bialek1997/Projekt_Automatyka_2/Matlab/Notatka 2.jpg

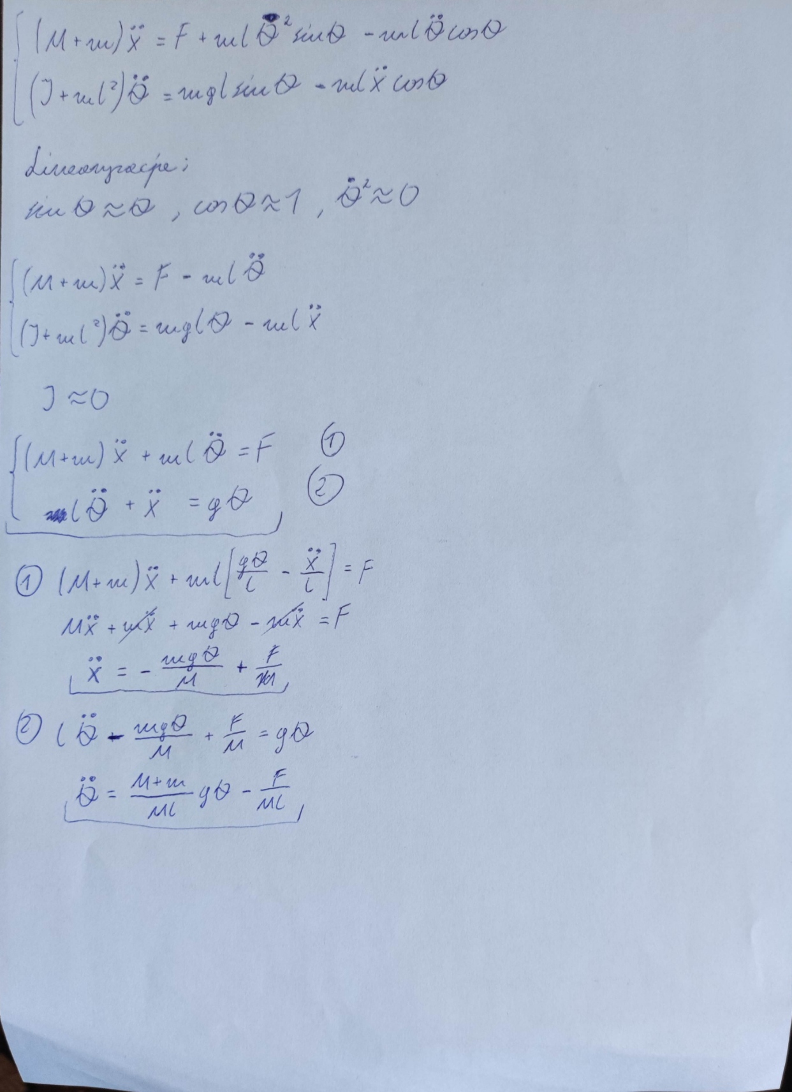
Matlab/Notatka 2.jpg
