bialek1997/Projekt_Automatyka_2/Matlab/Notatka 3.jpg

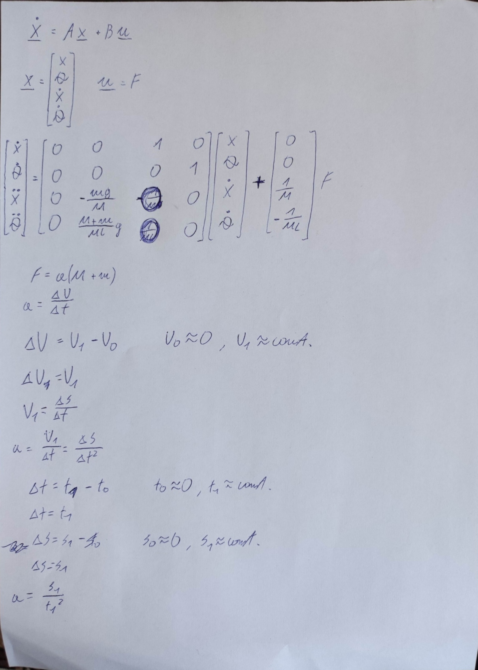
Matlab/Notatka 3.jpg
