bialek1997/Projekt_Automatyka_2/Zakupy.docx

Botland:

1x

https://botland.com.pl/silniki-krokowe/4849-silnik-krokowy-jk35hy26-0284-200-krokowobr-74v06a006nm-5904422306212.html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

1x

https://botland.com.pl/sterowniki-silnikow-moduly/15916-tb6612-dwukanalowy-sterownik-silnikow-135v12a-ze-zlaczami-adafruit-2448-5904422324995.html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

4x

https://botland.com.pl/kola-z-oponami/14245-kolo-z-opona-65x26mm-zolte.html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

ABC-RC:

4x

https://abc-rc.pl/product-pol-10260-Lacznik-osi-adapter-z-5mm-na-8mm-na-wal-silnika-os.html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

4x

https://abc-rc.pl/product-pol-9226-Lozysko-samonastawne-w-aluminiowej-obudowie-KP08-8mm-podpora-walka.html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

1x

https://abc-rc.pl/product-pol-9744-Zebatka-GT2-High-Quality-36-zebow-os-8mm-na-pasek-6mm-Drukarka-3D-RepRap-3D-CNC.html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

1x

https://abc-rc.pl/product-pol-9741-Zebatka-GT2-High-Quality-36-zebow-os-5mm-na-pasek-6mm-Drukarka-3D-RepRap-3D-CNC.html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

3 metry

https://abc-rc.pl/product-pol-6733-Pasek-zebaty-GT2-Black-napedowy-szerokosc-6mm-Tasma-do-drukarki-3D-CNC.html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

Nie wiem jak z prętami, daje te chromowane, najwyżej będzie trzeba zetrzeć warstwę chromu:

https://abc-rc.pl/product-pol-16557-Oska-5x150mm-chromowana-walek-do-budowy-robotow-i-projektow-DIY.html

i 2x:

https://abc-rc.pl/product-pol-16556-Oska-8x100mm-chromowana-walek-do-budowy-robotow-i-projektow-DIY.html

Nettigo:

2x

https://nettigo.pl/products/ogniwo-18650-li-ion-samsung-2800mah-z-zabezpieczeniem-pcm-nowe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

Oprócz tej listy za pewne będą do kupienia w castoramie czy coś takiego:

- dystanse nylonowe czy jakie się zajdzie -> najlepiej 40mm (20sztuk) ale pewnie nie ma to 20mm (40sztuk)

- kijek jakiś do wahadła

- kątowniki do trzymania wahadła i do zamontowania silnika

- śruby montażowe, w tym 20 sztuk śrub m4 o długości około 60mm

- pewnie jeszcze czegoś zapomniałem
