bialek1997/Projekt_Automatyka_2/Ćwiczenie 1 - Maciej Białecki.docx

Laboratorium

sterowania optymalnego

Sprawozdanie: Ćwiczenie 1 – Odwrócone wahadło

Autor: Maciej Białecki nr 239395

1. Wstęp

Celem ćwiczenia była adaptacja sterowania LQR dla zamodelowanego obiektu odwróconego wahadła zamocowanego na wózku poruszającego się w osi poziomej. Ze względu na zbieżność ćwiczenia z projektem realizowanym z innego przedmiotu „Projekt Automatyka II” postanowiłem scalić zdobytą wiedzę oraz umiejętności i opisać rzeczywisty przypadek omawianego urządzenia.

2. Obiekt rzeczywisty

Projektowane wahadło odwrócone składa się z dwóch głównych elementów:

1. Wózka
2. Wahadła

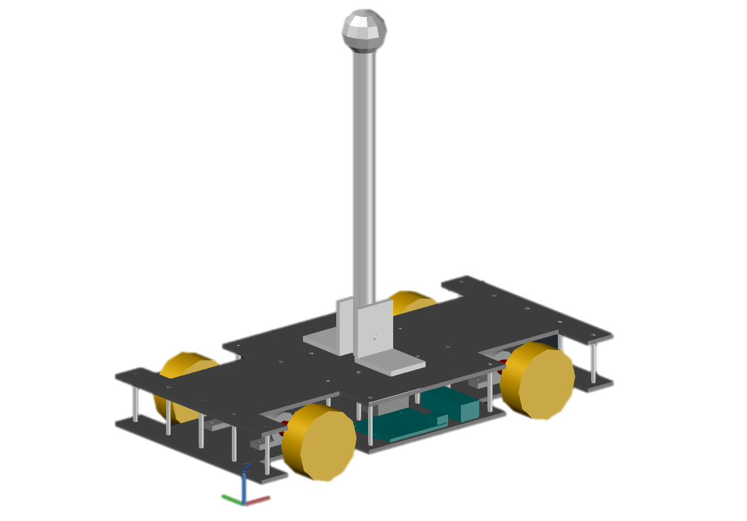
[picture p3: figure]
Obraz zawierający lego, zabawka Opis wygenerowany automatycznie

Wózek

Wahadło

Rysunek 2.1 – Model 3D wahadła odwróconego

gdzie za poruszanie się obiektu odpowiedzialny jest silnik krokowy JK42HS48-0806 dysponujący momentem obrotowym 0.31 Nm. Moment przekazywany jest na wał za pomocą przekładni z paskiem zębatym. Przy zastosowaniu kół o średnicy 67 mm maksymalna siła może mieć wartość:

F_(MAX) = M/(r∙sinα)≈(0.31 Nm)/(0.0335 m∙1)≈9.25 N

Wartość ta będzie istotna przy ograniczeniu naszego modelu.

Regulator LQR zostanie zaimplementowany w układzie mikroprocesorowym Arduino Uno REV3 (Klon) z zegarem 16MHz. Odczyt wychylenia wahadła będzie interpretowany z danych żyroskopu poprzez komunikację szeregową.

Za zasilanie urządzenia odpowiadają akumulatory Li – Ion, a tryb pracy urządzenia będzie ustalany poprzez aplikację mobilną i komunikację Bluetooth.

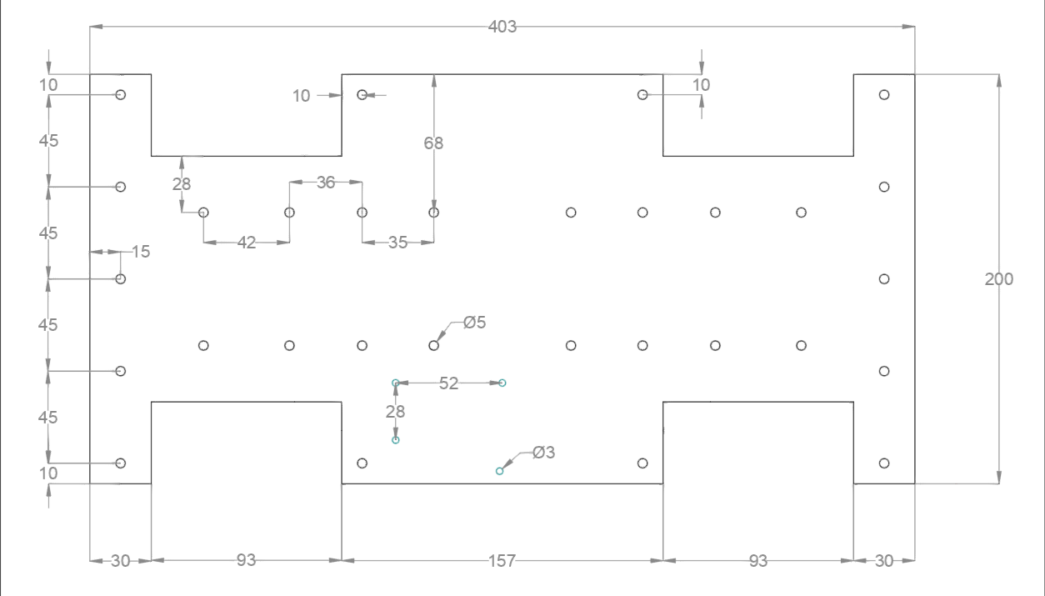
[picture p4: figure]

Rysunek 2.2 – Wymiary platformy wózka

Konstrukcja urządzenia charakteryzuje się szerokością 200 mm oraz długością wynoszącą 403 mm. Samo wahadło od punktu zaczepienia na długość 500 mm, a waga wahadła wynosi około 1.5 kg.

3. Model matematyczny wahadła odwróconego

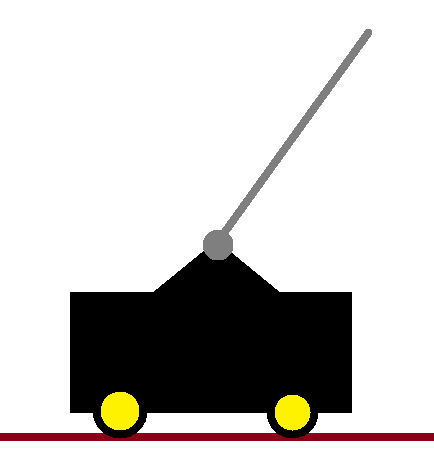
[picture p5: figure]

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
Rysunek 3.1 – Schemat wahadła odwróconego

gdzie:

- L – długość wahadła od punktu podparcia do środka ciężkości (w przybliżeniu połowa długości wahadła)
- Θ – kąt wychylenia wahadła od osi pionowej
- F – siła działająca na obiekt
- Fx – siła działająca na wahadło w osi X
- Fy – siła działająca na wahadło w osi Y
- M – masa wózka
- m – masa wahadła

Ponieważ rozważany jest obiekt rzeczywisty, siła tarcia nie została uwzględniona. Wynika to z faktu iż takie dane mogą zostać wyznaczone dopiero na etapie testów i są zależne od warunków w jakich będzie poruszać się wahadło.

Pozycje wahadła można określić za pomocą wzorów:

x_w =x+L∙sinθ y_w =L∙cosθ

gdzie: x – położenie wahadła w osi X

Równania sił dla całego obiektu:

- oś X: M∙x=F-F_x
- oś Y: F_y -m∙g=m∙y_w

Rozważamy oś X, należy wyznaczyć Fx :

F_x =m∙x_w

więc:

x_w =x+L∙θ∙cosθ

x_w =x-L∙θ^2 ∙sinθ+L∙θ∙cosθ

możemy wyznaczyć Fx :

F_x =m∙(x-L∙θ^2 ∙sinθ+L∙θ∙cosθ)

znając Fx możemy podstawić pod równanie sił w osi X:

M∙x=F-m∙(x-L∙θ^2 ∙sinθ+L∙θ∙cosθ)

ostatecznie:

(M+m)∙x=F+m∙L∙θ^2 ∙sinθ+m∙L∙θ∙cosθ

Rozważamy oś Y, należy wyznaczyć yw :

y_w =-L∙θ∙sinθ

y_w =-L∙θ^2 ∙cosθ-L∙θ∙sinθ

ostatecznie:

F_y -m∙g=m∙(-L∙θ^2 ∙cosθ-L∙θ∙sinθ)

Suma momentów działająca na wahadło względem środka ciężkości może być dana wzorem:

F_y ∙L∙ sinθ-F_x ∙L∙ cosθ=I∙θ

gdzie I – moment bezwładności wahadła

Wykorzystując powyższą zależność i podstawiając siły działające na poszczególne osie otrzymujemy:

(m∙g+m∙(-L∙θ^2 ∙cosθ-L∙θ∙sinθ))∙L∙ sinθ-

-m∙(x-L∙θ^2 ∙sinθ+L∙θ∙cosθ)∙L∙ cosθ=I∙θ

ostatecznie:

m∙g∙L∙sinθ-m∙L^2 ∙θ-m∙x∙L∙cosθ=I∙θ

Pozwala nam to na wyznaczenie zestawu równań opisujących nieliniowy model matematyczny wahadła odwróconego:

(M+m)∙x=F+m∙L∙θ^2 ∙sinθ+m∙L∙θ∙cosθ

(I+m∙L^2 )∙θ=m∙g∙L∙sinθ-m∙x∙L∙cosθ

4. Linearyzacja i zapis w przestrzeni stanów modelu wahadła odwróconego

Dla zlinearyzowanego opisu matematycznego należy przyjąć, że żyroskop zamontowany na wahadle jest nieważki dzięki czemu moment bezwładności:

I≈0

oraz:

sinθ≈θ cosθ≈1 θ^2 ≈0

Dla takich rozważań zestaw równań ma postać:

(M+m)∙x=F-m∙L∙θ

x+L∙θ=g∙θ

po przekształceniu:

x=-(m∙g∙θ)/M+F/M

θ=(M+m)/(M∙L)∙g∙θ-F/(M∙L)

Zapis w przestrzeni stanów:

x=Ax+Bu

gdzie:

x=[xθxθ] u=F

ostatecznie:

[xθxθ]=[0, 0, 1, 00, 0, 0, 10, -(m∙g)/M, 0, 00, (M+m)/(M∙L)∙g, 0, 0][xθxθ]+[001/M-1/(M∙L)]F

5. Realizacja układu w programie Matlab oraz Simulink

Model nieliniowy wahadła odwróconego można zbudować korzystając z wzorów:

(M+m)∙x=F+m∙L∙θ^2 ∙sinθ+m∙L∙θ∙cosθ

(I+m∙L^2 )∙θ=m∙g∙L∙sinθ-m∙x∙L∙cosθ

gdzie:
I≈0

ostatecznie:

(M+m)∙x=F+m∙L∙θ^2 ∙sinθ+m∙L∙θ∙cosθ

m∙L^2 ∙θ=m∙g∙L∙sinθ-m∙x∙L∙cosθ

Dla takich równań obiekt ma postać:

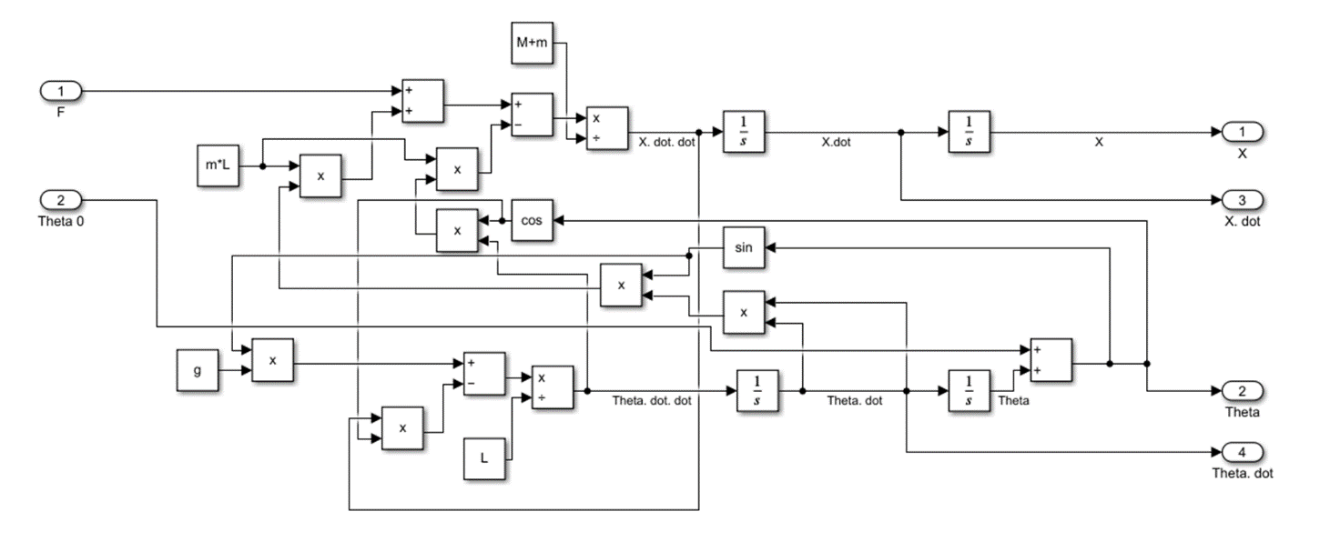
[picture p6: figure]

Rysunek 5.1 – Model obiektu zrealizowanego w Simulinku

gdzie Theta 0 to wartość początkowa wychylenia wahadła od osi pionowej. Układ z zaimplementowanym regulatorem LQR ma postać:

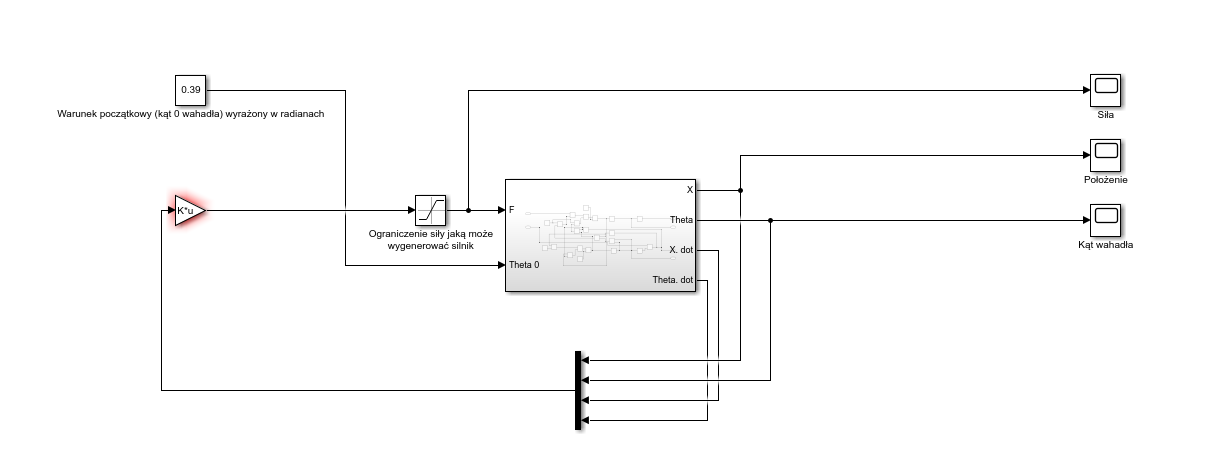
[picture p7: figure]

Rysunek 5.2 – Układ z regulatorem LQR zrealizowany w Simulinku

Dla takiego układu niezbędne jest wyznaczenie parametrów regulatora LQR. W tym celu wykorzystałem wbudowaną metodę lqr(). Skrypt dla przykładowych ustawień ma postać:

M = 1.5; %Masa platformy

m = 0.2; %Masa wahadła

L = 0.25; %Długość od mocowania wahadła do środka ciężkości

g = 9.80665; %Przyśpieszenie ziemskie

A = [0, 0, 1, 0;

0, 0, 0, 1;

0, -(m*g/M), 0, 0;

0, ((M+m)/M*L)*g, 0, 0];

B = [0;

0;

(1/M);

-(1/M*L)];

C = [1, 1, 1, 1];

D = 0;

%Test na obserwowanie

ob = obsv(A,C);

rank(ob);

%Test na sterowanie

ct = ctrb(A,B);

rank(ct);

Q = diag([1000, 100, 0, 0]);

R = 1;

K = lqr(A,B,Q,R);

Przy badaniu układu rozważane będą dwa warianty stabilizacji wahadła:

a) Powrót wahadła do pionu, Θ=0° w ciągu 5 sekund od wartości początkowej wynoszącej Θ0=45°.
b) Powrót wahadła do pionu, Θ=0° od wartości początkowej wynoszącej Θ0=45° z ograniczeniem siły wynikającej z specyfikacji użytego silnika FMAX=9.25 N.

Wariant a)

Dla stabilizacji w czasie 5 sekund najlepiej prezentują się parametry:

Q= [1, 0, 0, 00, 1000, 0, 00, 0, 500, 00, 0, 0, 0], R=1

Kąt wychylenia wahadła:

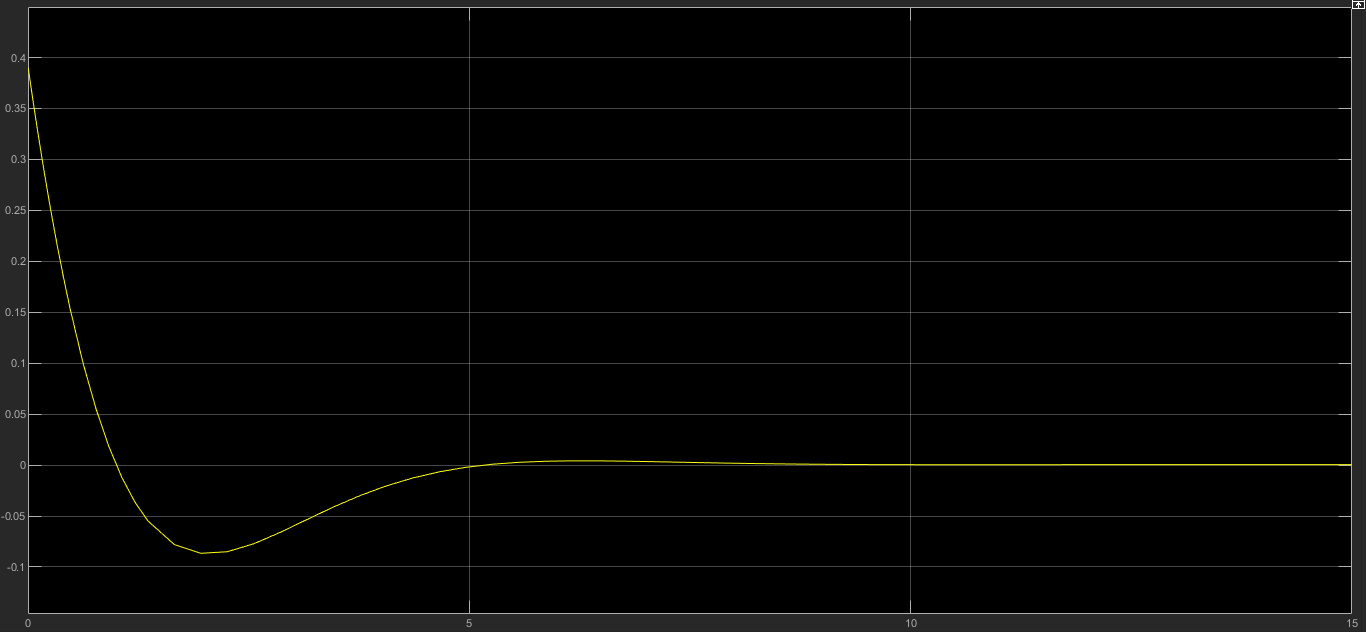
[picture p8: figure]

Położenie wózka:

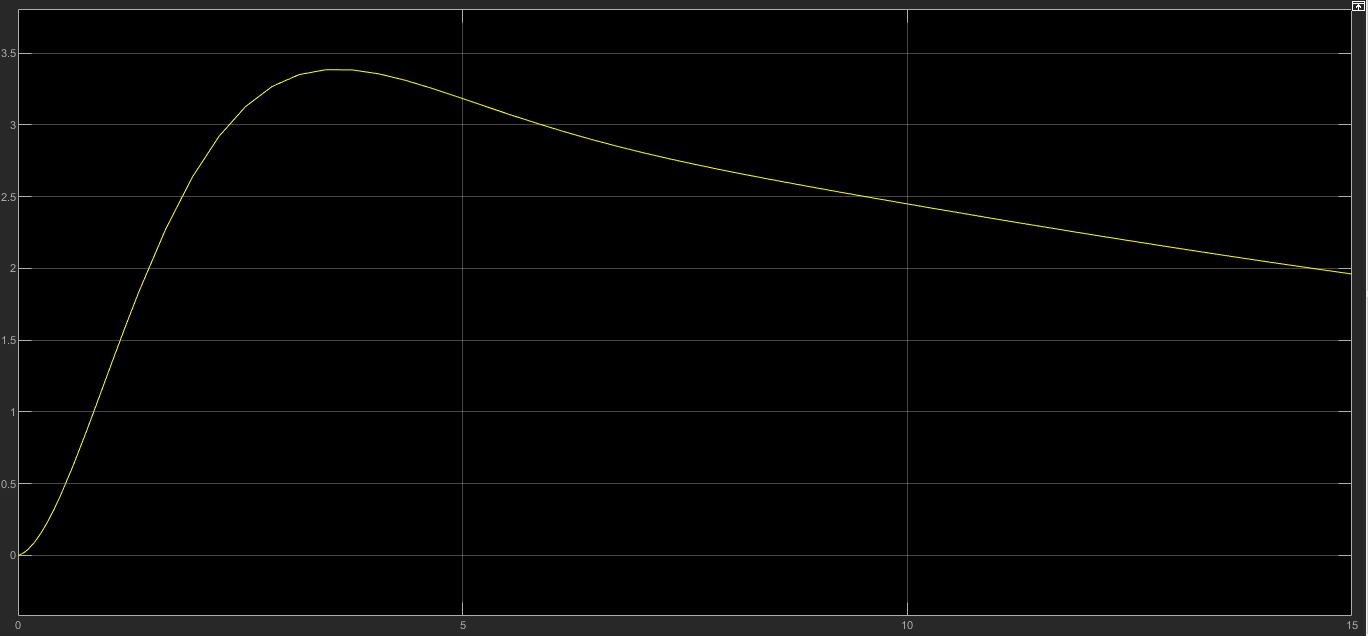
[picture p9: figure]

Położenie wózka – do momentu zatrzymania (80 sekund):

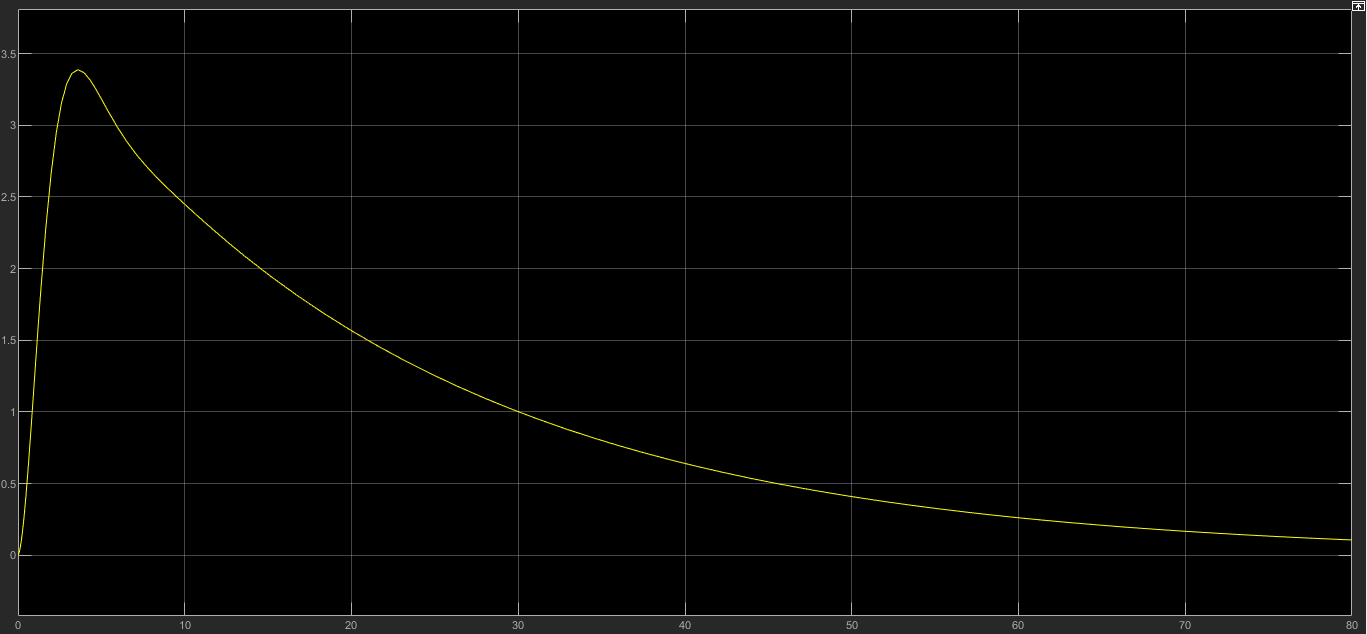
[picture p10: figure]

Siła generowana przez silnik:

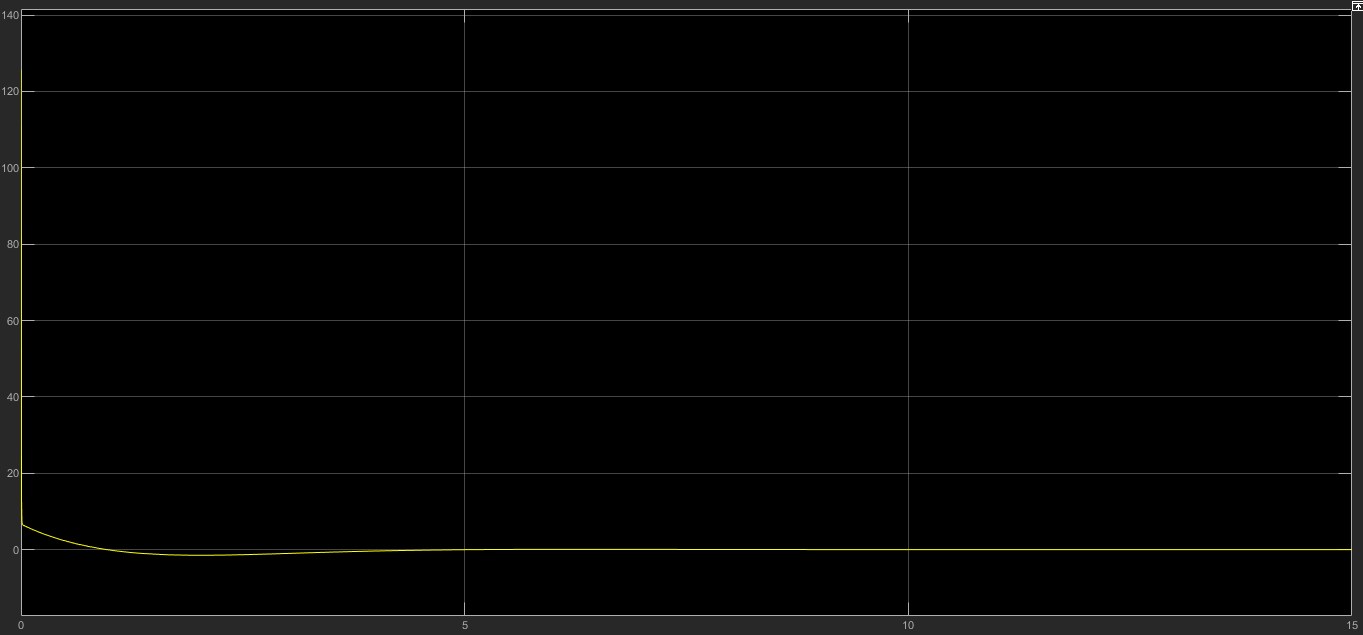
[picture p11: figure]
Obraz zawierający stół Opis wygenerowany automatycznie

Wariant b)

Dla ograniczenia siły korzystnie wypadły parametry:

Q= [10, 0, 0, 00, 1000, 0, 00, 0, 100, 00, 0, 0, 0], R=1

Kąt wychylenia wahadła:

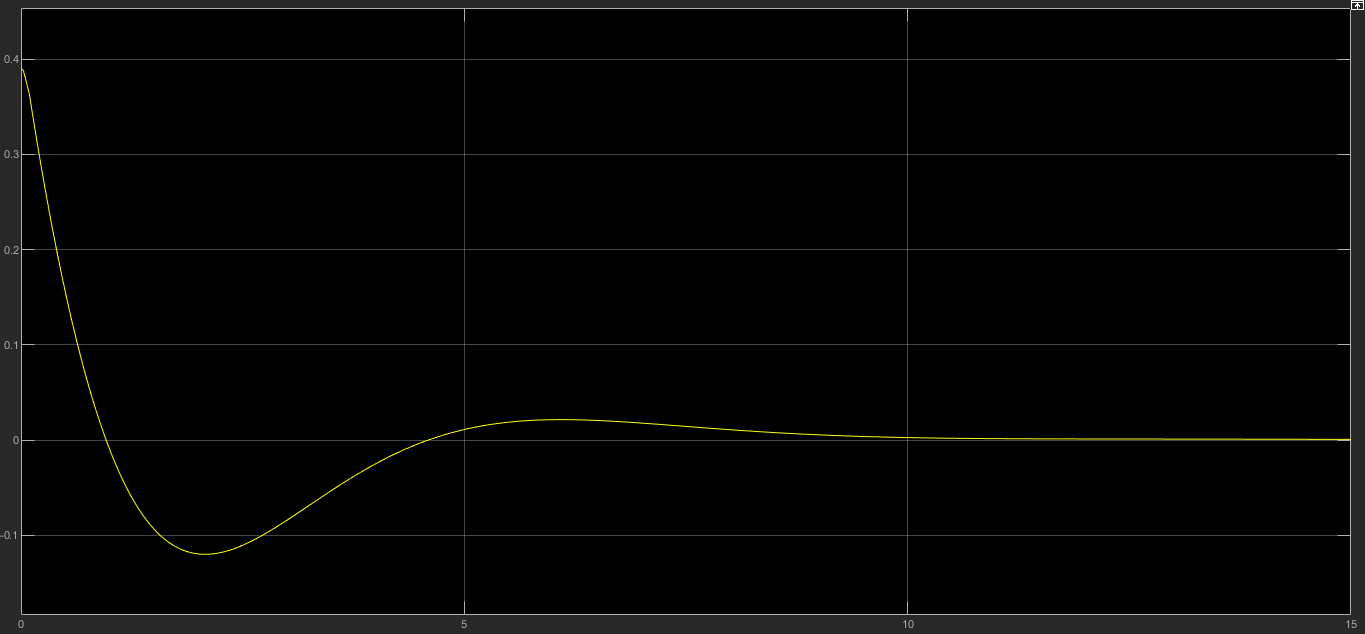
[picture p12: figure]
Obraz zawierający tekst Opis wygenerowany automatycznie

Położenie wózka:

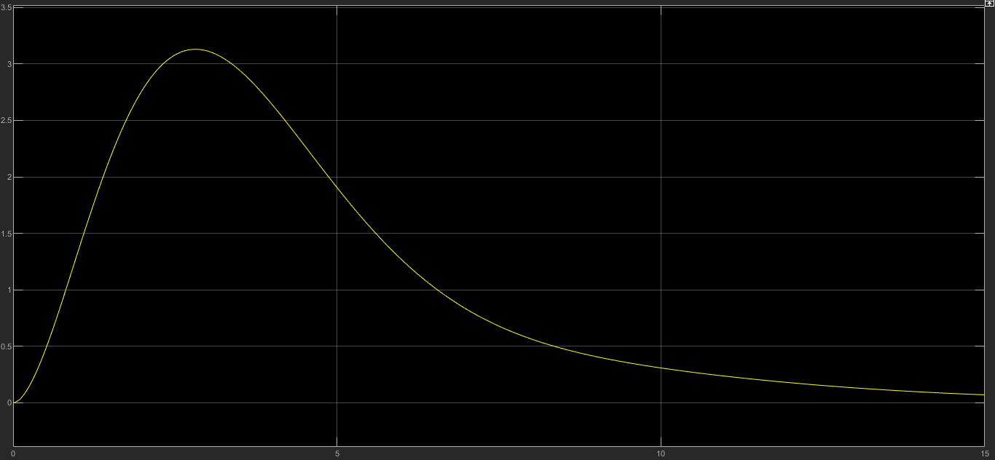
[picture p13: figure]

Siła generowana przez silnik:

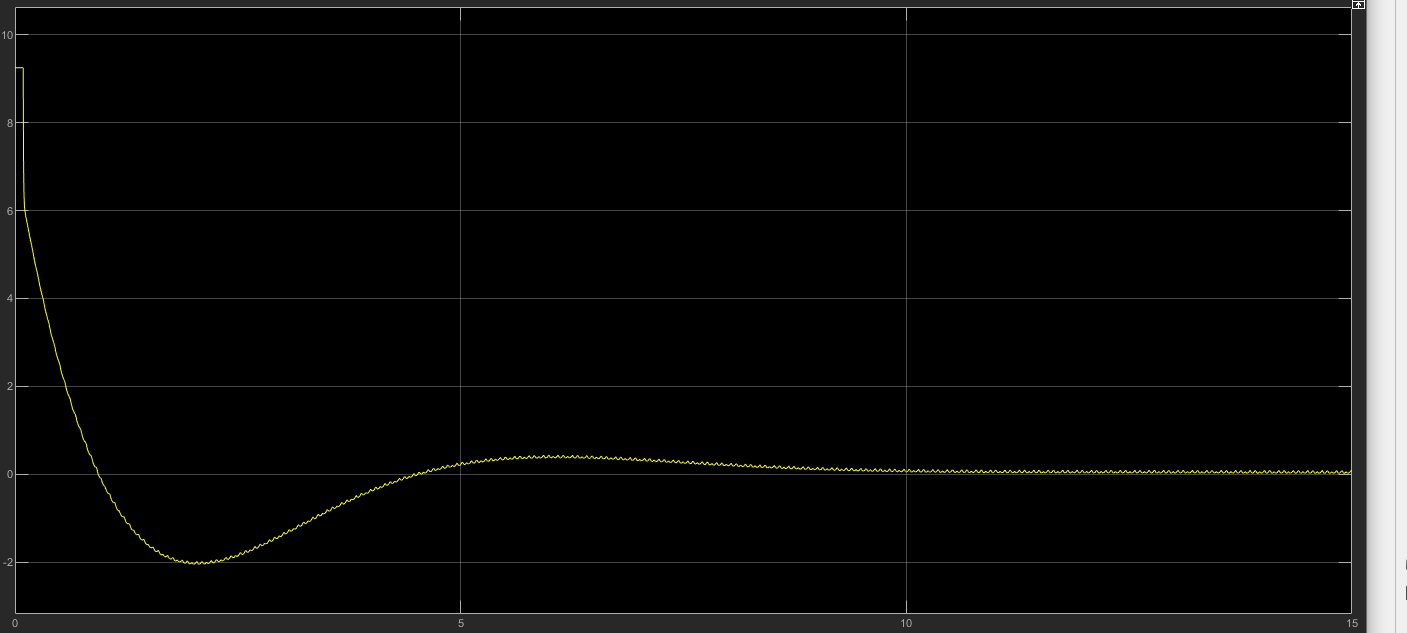
[picture p14: figure]

6. Wnioski

Podsumowując powyższe badania należy ukształtować wnioski podparte założeniami projektu. Przede wszystkim można jednoznacznie stwierdzić iż jest możliwe ustabilizowanie odwróconego wahadła dla czasu ciągłego.

Jednakże, pierwszy badany przypadek prezentuje wyniki, które stanowczo odbiegają od rzeczywistego układu. Nie jest możliwe wytworzenie ponad 120 N przez silnik w nieskończenie krótkim czasie. Dodatkowo wózek porusza się przez ponad 70 sekund bez użycia siły jedynie wytracając energię. Niebagatelny wpływ ma na to pominięcie tarcia w analizie i budowie modelu.

Drugi badany przypadek (który jest bliższy rzeczywistym warunkom) pokazuje, że z użyciem dostępnej nam aparatury, możliwe jest sukcesywne sterowanie obiektem. Niemniej, należy wziąć pod uwagę fakt, iż implementowany algorytm będzie mógł pracować wyłącznie z czasem dyskretnym i wieloma ograniczeniami. Chodź badania modelu zakończyły się sukcesem, dopiero testy rzeczywistego układu pokażą jak bardzo odbiega on od ideału.
