bialek1997/Projekt_Automatyka_2/Rysunki/Screenshots.docx

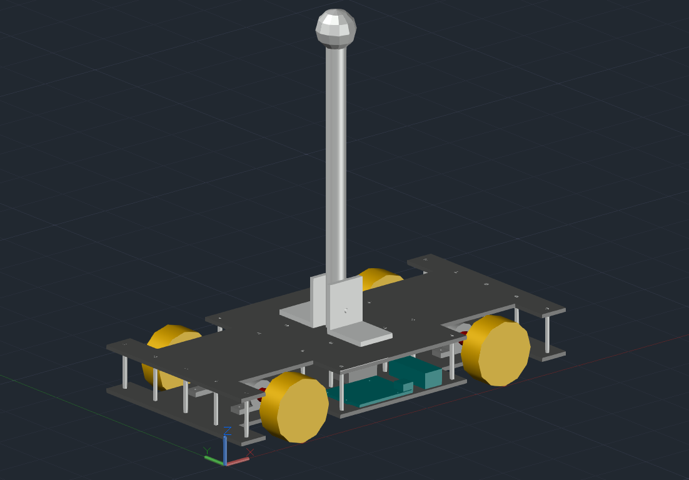
[picture p15: figure]
Obraz zawierający lego, zabawka Opis wygenerowany automatycznie
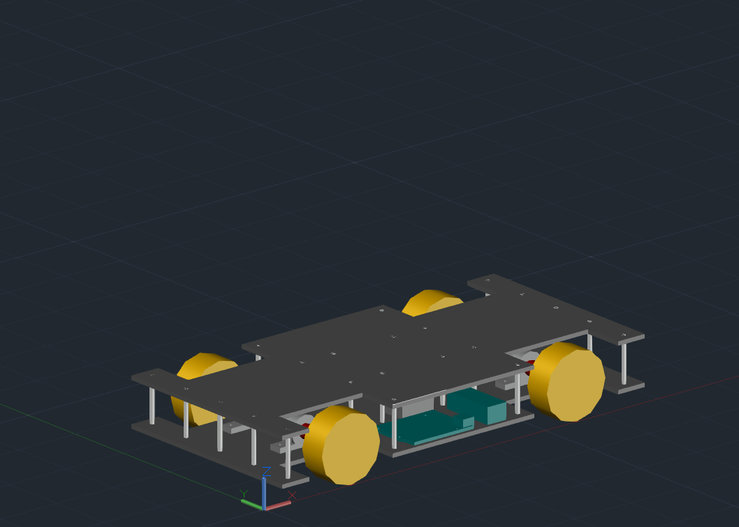
[picture p16: figure]
Obraz zawierający lego, zabawka Opis wygenerowany automatycznie
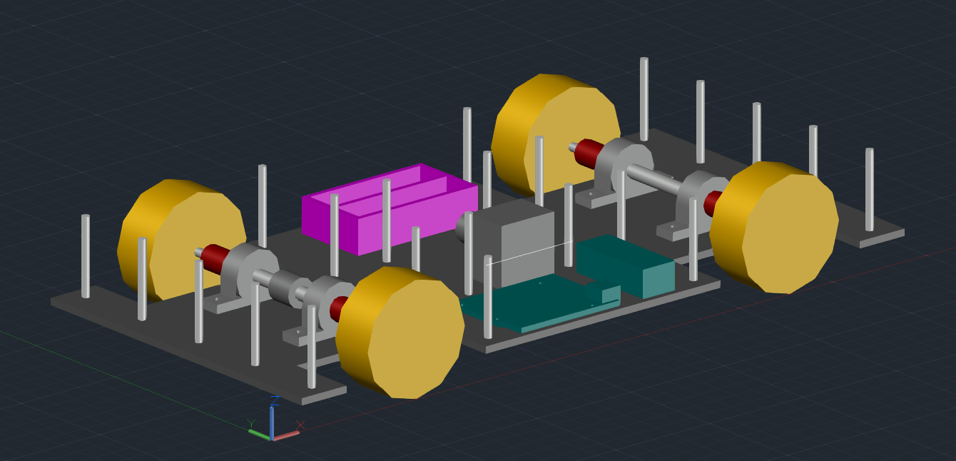
[picture p17: figure]
Obraz zawierający zabawka, lego, urodziny Opis wygenerowany automatycznie
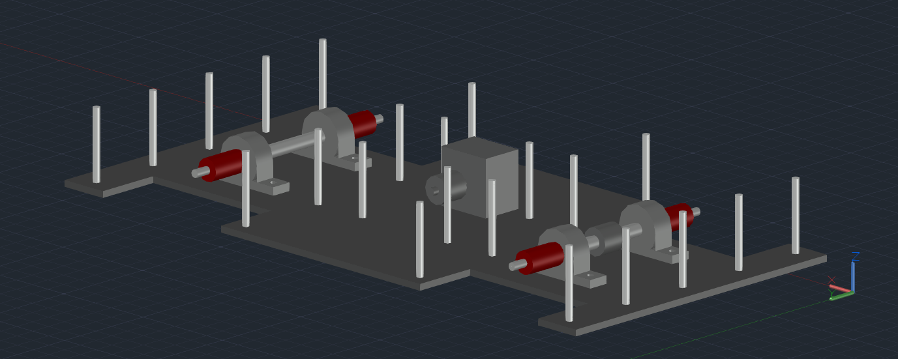
[picture p18: figure]
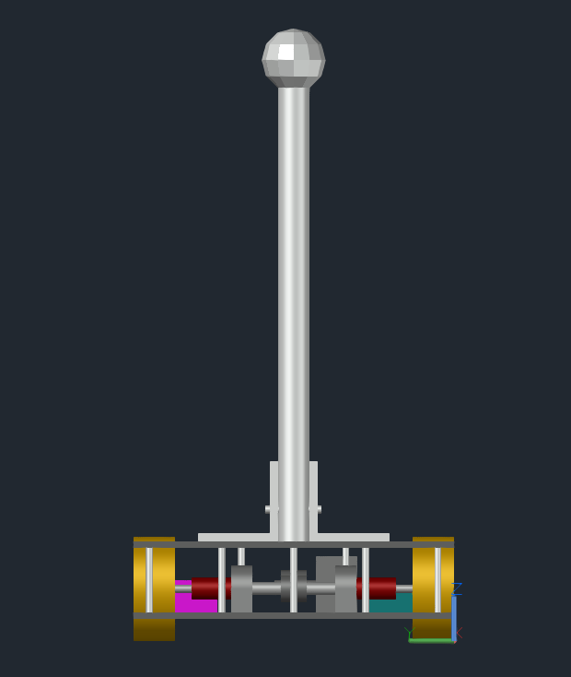
[picture p19: figure]
Obraz zawierający tekst Opis wygenerowany automatycznie
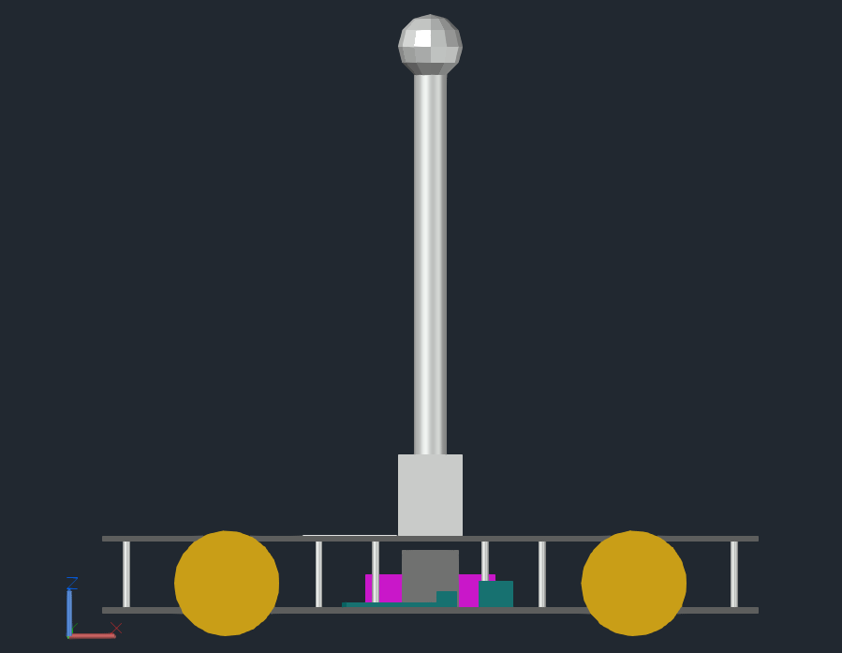
[picture p20: figure]
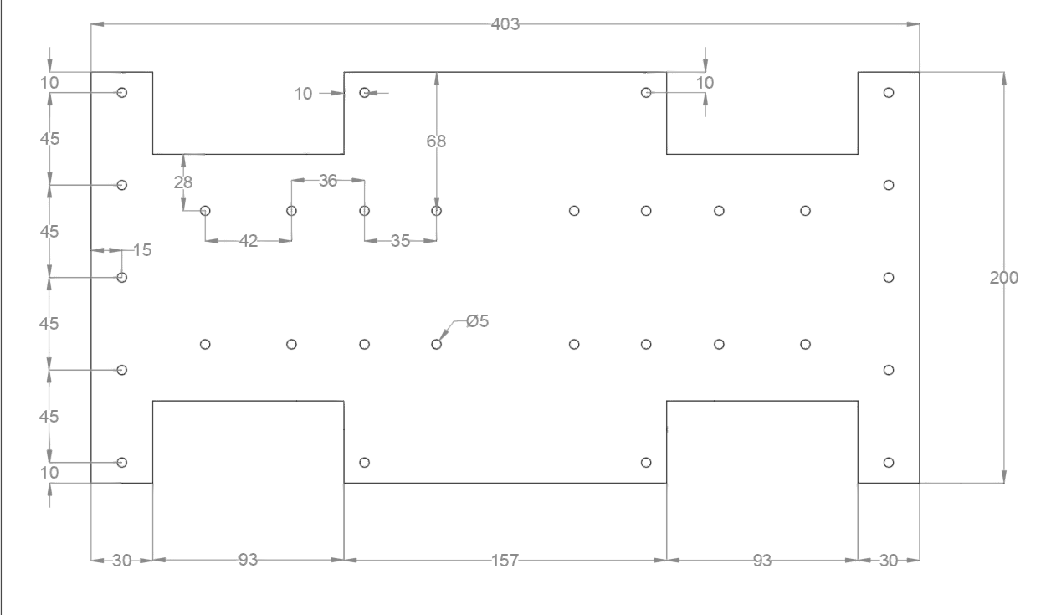
[picture p21: figure]
