bialek1997/Projekt_Automatyka_2/Matlab/Notatka 1.jpg

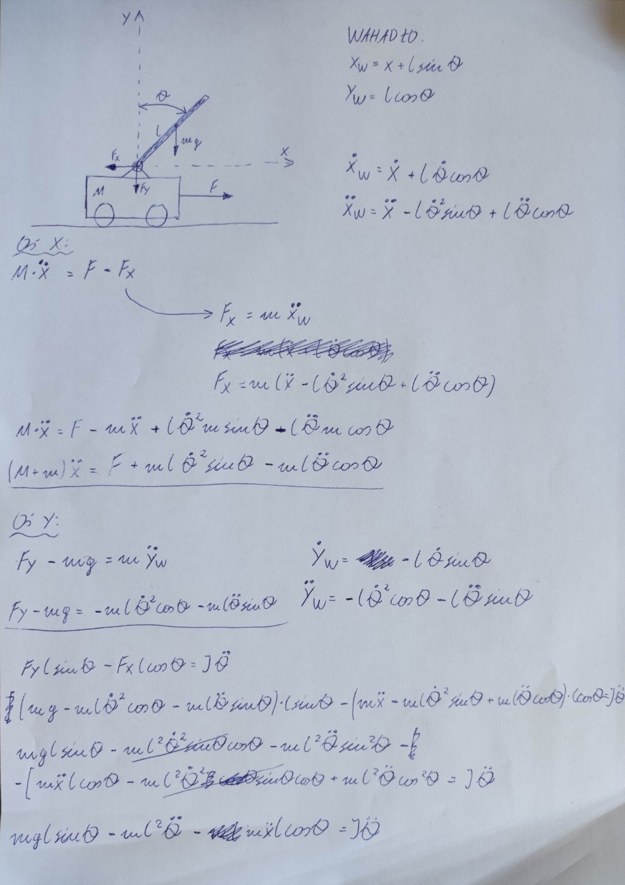
Matlab/Notatka 1.jpg
