bialek1997/Projekt_Automatyka_2/Matlab/Notatka 4.jpg

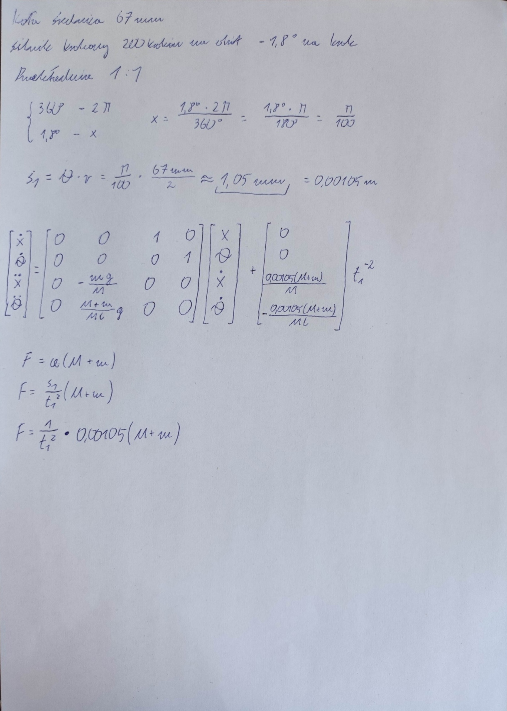
Matlab/Notatka 4.jpg
