bialek1997/Projekt_Automatyka_2/(list of files, cad)

Other CAD files:
Rysunki/Plaforma górna wymiary.dwg
Rysunki/Widok platformy poglądowy.dwg
Rysunki/Drawing1.dwg
Rysunki/Plaforma dolna wymiary.dwg
Rysunki/3D All.dwg
